PecaJosef/PCK-HC/Firmware/TouchGFX/assets/images/image-mesh-gradient_480x1920.png

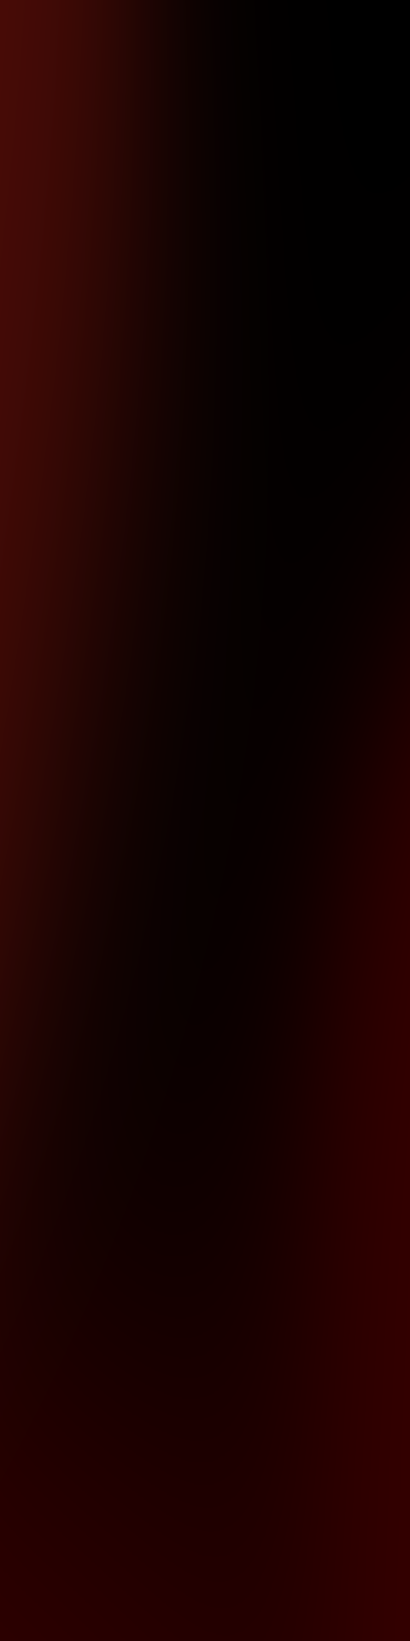
Firmware/TouchGFX/assets/images/image-mesh-gradient_480x1920.png
