PecaJosef/PCK-HC/Firmware/TouchGFX/assets/images/image-mesh-gradient 3.png

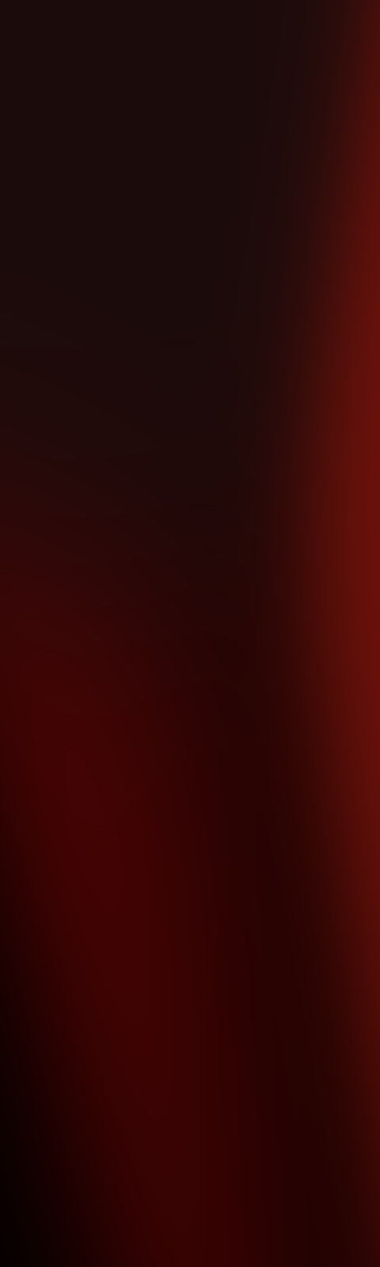
Firmware/TouchGFX/assets/images/image-mesh-gradient 3.png
