PecaJosef/PCK-HC/Firmware/TouchGFX/assets/images/image-mesh-gradient 2.png

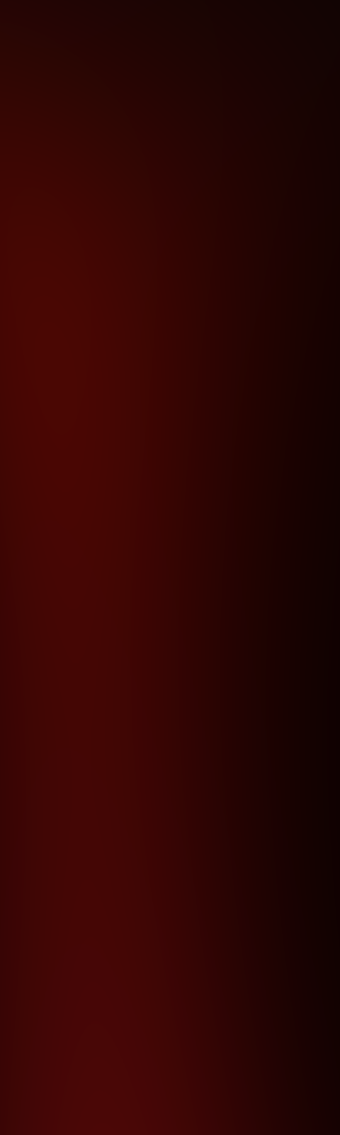
Firmware/TouchGFX/assets/images/image-mesh-gradient 2.png
