PecaJosef/PCK-HC/Firmware/TouchGFX/assets/images/image-mesh-gradient.png

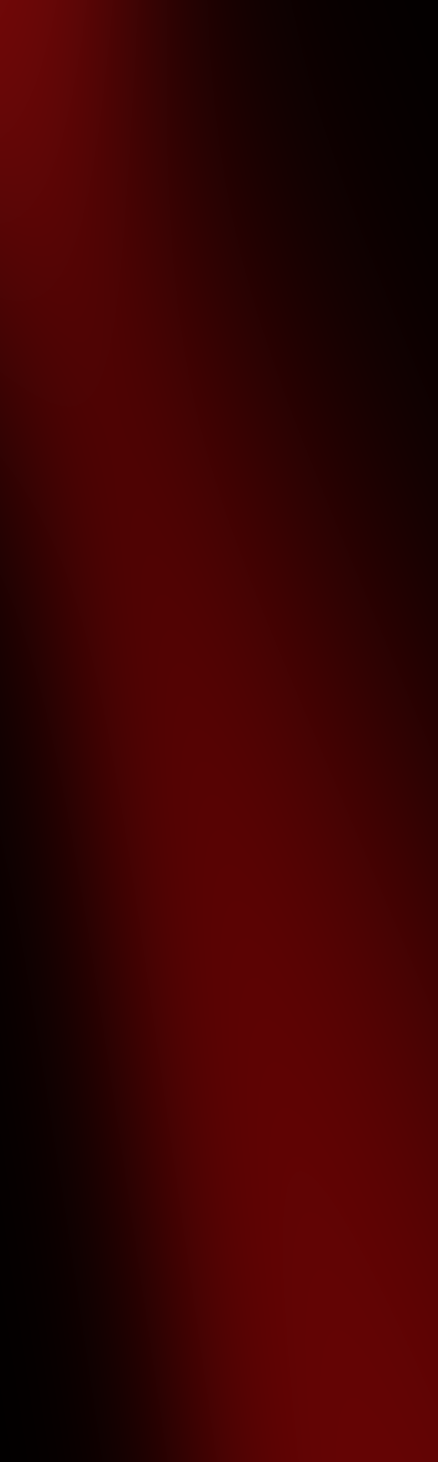
Firmware/TouchGFX/assets/images/image-mesh-gradient.png
