PecaJosef/PCK-HC/Firmware/TouchGFX/assets/images/PCK-ST1_120x120.png

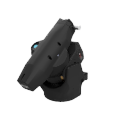
Firmware/TouchGFX/assets/images/PCK-ST1_120x120.png
