PecaJosef/PCK-HC/Firmware/TouchGFX/assets/images/PCK-ST1_240x240.png

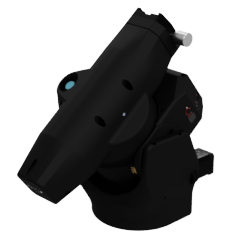
Firmware/TouchGFX/assets/images/PCK-ST1_240x240.png
