PecaJosef/PCK-HC/Controller/Controller board/Controller_board/As built V0.1/Controller_board.kicad_pcb

## KiCad design Controller/Controller board/Controller_board/As built V0.1/Controller_board.kicad_pcb (2026-10-08)

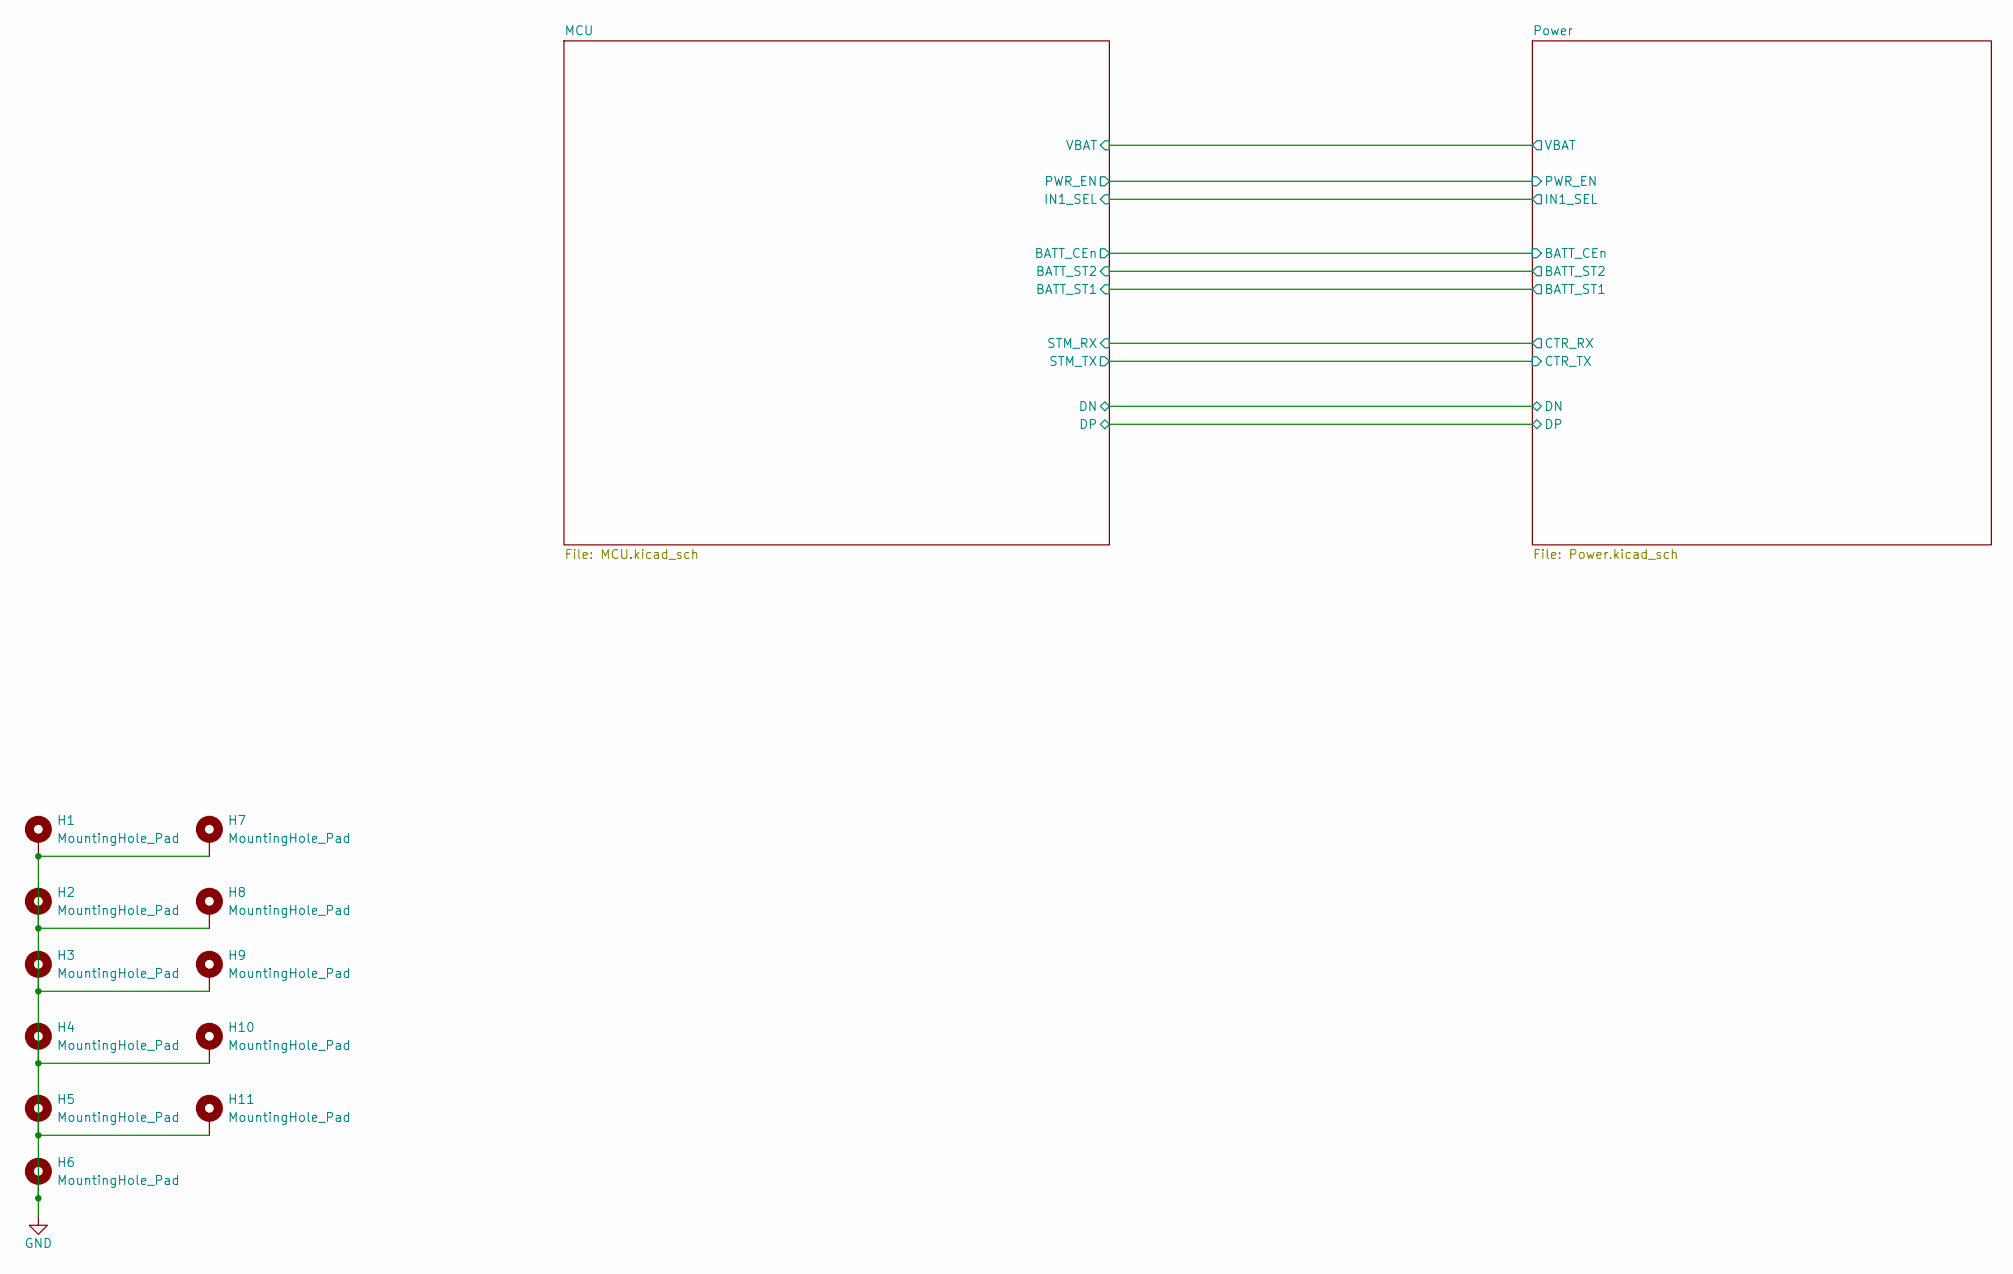
[picture p7: schematic Controller_board.kicad_sch]

Parts:
H1, H2, H3, H4, H5, H6, H7, H8, H9, H10, H11: MountingHole_Pad; MountingHole_3.2mm_M3_DIN965_Pad

Connections:
GND: H1.1, H2.1, H3.1, H4.1, H5.1, H6.1, H7.1, H8.1, H9.1, H10.1, H11.1; also elsewhere on the board

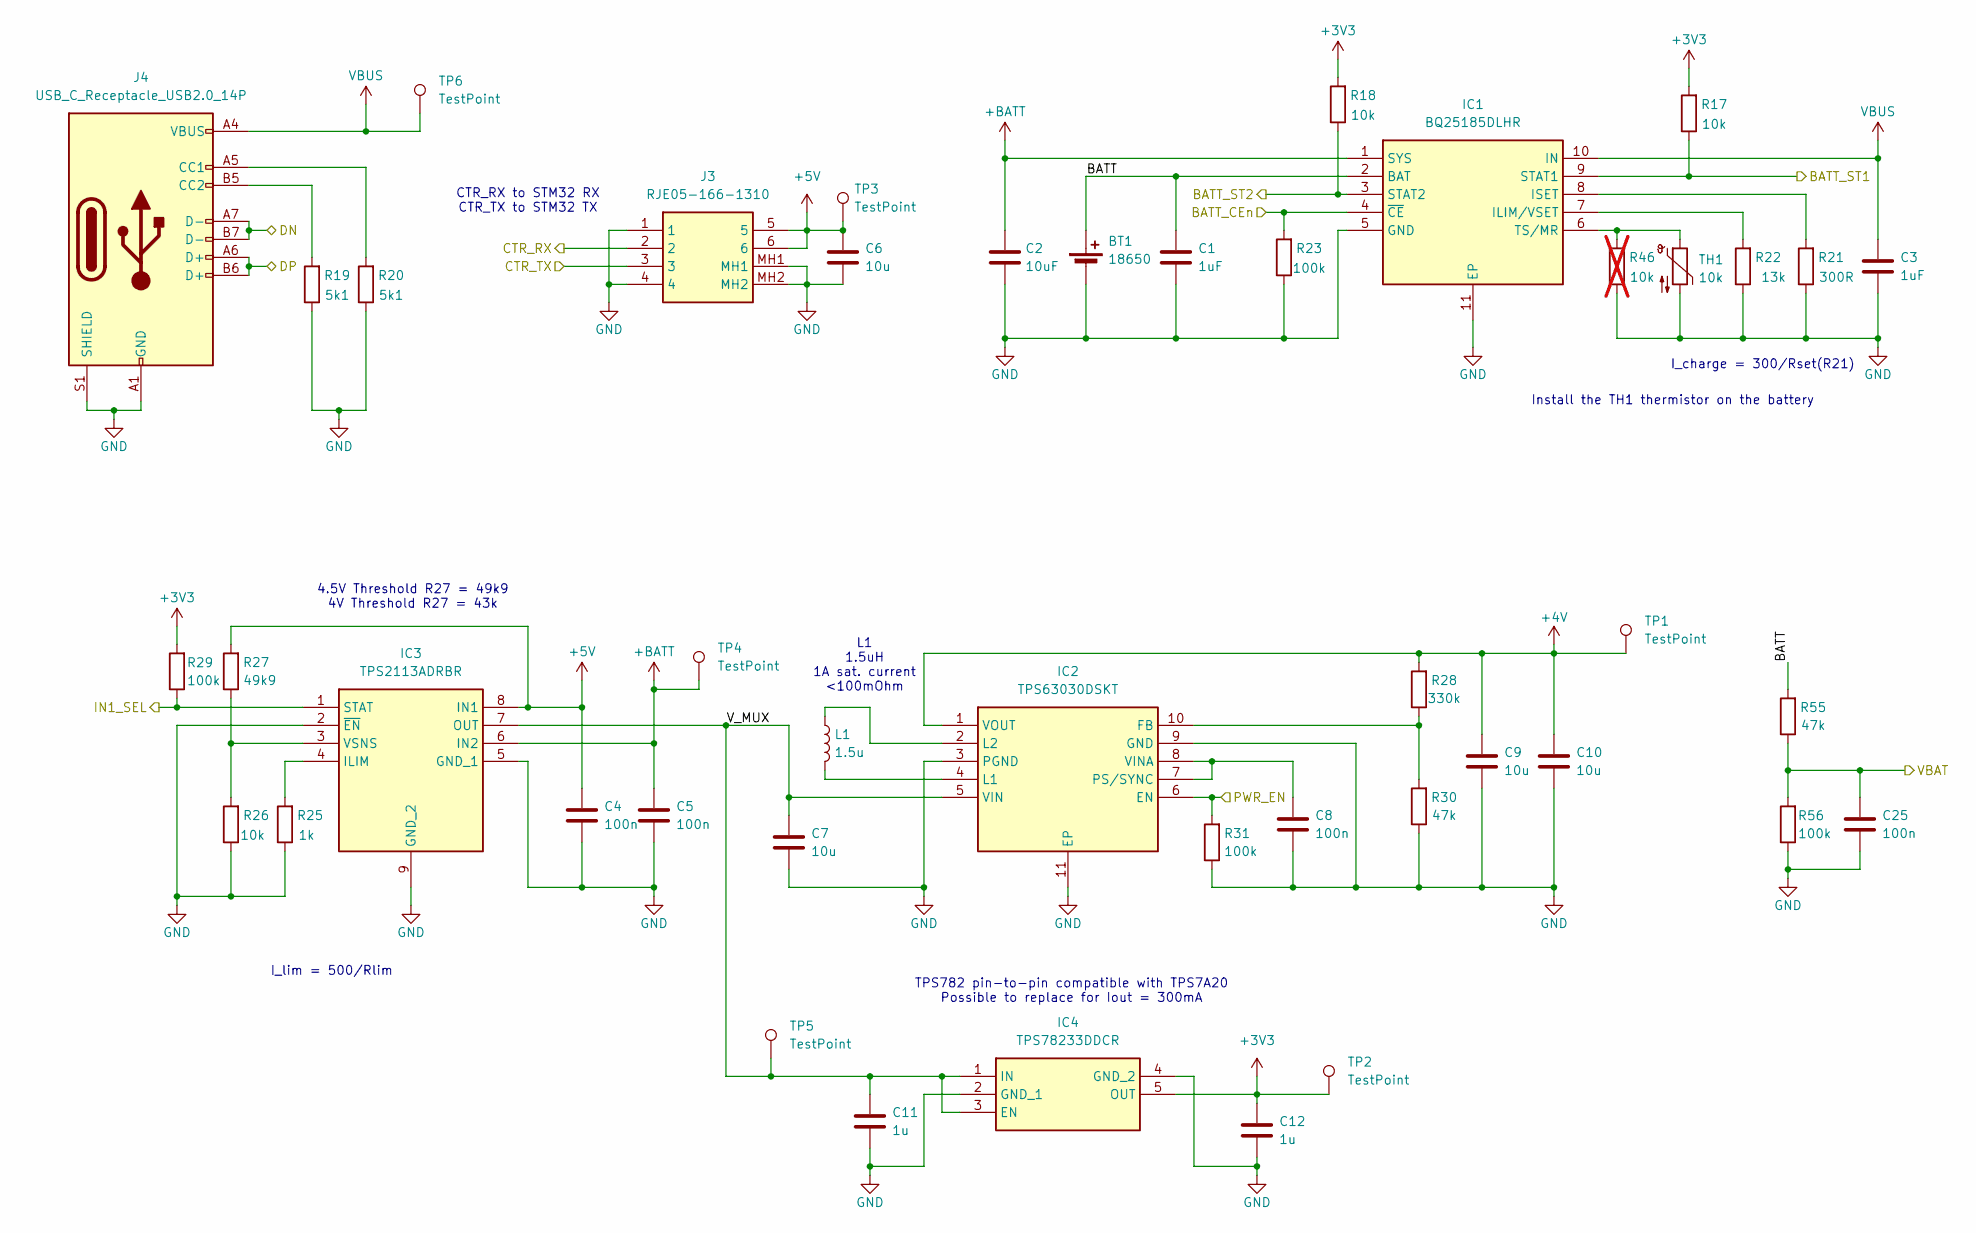
[picture p8: schematic Power.kicad_sch]

Parts:
BT1: 18650; BatteryHolder_Keystone_1042_1x18650
C1, C3: 1uF; C_0603_1608Metric
C2: 10uF; C_0603_1608Metric
C4, C5, C8, C25: 100n; C_0603_1608Metric
C6, C7, C9, C10: 10u; C_0603_1608Metric
C11, C12: 1u; C_0603_1608Metric
IC1: BQ25185DLHR; SON40P220X200X80-11N; Mouser Part Number 595-BQ25185DLHR
IC2: TPS63030DSKT; SON50P250X250X80-11N-D; Mouser Part Number 595-TPS63030DSKT
IC3: TPS2113ADRBR; SON65P300X300X100-9N-D; Mouser Part Number 595-TPS2113ADRBR
IC4: TPS78233DDCR; SOT95P280X110-5N; Mouser Part Number 595-TPS78233DDCR
J3: RJE05-166-1310; RJE051661310; Mouser Part Number 523-RJE05-166-1310
J4: USB_C_Receptacle_USB2.0_14P; USB_C_Receptacle_HCTL_HC-TYPE-C-16P-01A
L1: 1.5u; L_1008_2520Metric
R17, R18, R26: 10k; R_0603_1608Metric
R19, R20: 5k1; R_0603_1608Metric
R21: 300R; R_0603_1608Metric
R22: 13k; R_0603_1608Metric
R23, R29, R31, R56: 100k; R_0603_1608Metric
R25: 1k; R_0603_1608Metric
R27: 49k9; R_0603_1608Metric
R28: 330k; R_0603_1608Metric
R30, R55: 47k; R_0603_1608Metric
R46: 10k; R_0603_1608Metric; not fitted
TH1: 10k; JST_PH_B2B-PH-K_1x02_P2.00mm_Vertical
TP1, TP2, TP3, TP4, TP5, TP6: TestPoint; TestPoint_Pad_D1.5mm

Connections:
+3V3: C12.1, IC4.5 (OUT), R17.2, R18.2, R29.2, TP2.1; also elsewhere on the board
+4V: C9.1, C10.1, IC2.1 (VOUT), R28.2, TP1.1; also elsewhere on the board
+5V: C4.1, C6.1, IC3.8 (IN1), J3.5, J3.6, R27.2, TP3.1
+BATT: C2.1, C5.1, IC1.1 (SYS), IC3.6 (IN2), TP4.1
/MCU/BATT_CEn: IC1.4 (~CE), R23.2; also elsewhere on the board
/MCU/BATT_ST1: IC1.9 (STAT1), R17.1; also elsewhere on the board
/MCU/BATT_ST2: IC1.3 (STAT2), R18.1; also elsewhere on the board
/MCU/DN: J4.A7 (D-), J4.B7 (D-); also elsewhere on the board
/MCU/DP: J4.A6 (D+), J4.B6 (D+); also elsewhere on the board
/MCU/IN1_SEL: IC3.1 (STAT), R29.1; also elsewhere on the board
/MCU/PWR_EN: IC2.6 (EN), R31.2; also elsewhere on the board
/MCU/STM_RX: J3.2; also elsewhere on the board
/MCU/STM_TX: J3.3; also elsewhere on the board
/MCU/VBAT: C25.1, R55.1, R56.2; also elsewhere on the board
/Power/BATT: BT1.1 (+), C1.1, IC1.2 (BAT), R55.2
/Power/V_MUX: C7.1, C11.1, IC2.5 (VIN), IC3.7 (OUT), IC4.1 (IN), IC4.3 (EN), TP5.1
GND: BT1.2 (-), C1.2, C2.2, C3.2, C4.2, C5.2, C6.2, C7.2, C8.2, C9.2, C10.2, C11.2, C12.2, C25.2, IC1.5 (GND), IC1.11 (EP), IC2.3 (PGND), IC2.9 (GND), IC2.11 (EP), IC3.2 (~EN), IC3.5 (GND_1), IC3.9 (GND_2), IC4.2 (GND_1), IC4.4 (GND_2), J3.1, J3.4, J3.MH1, J3.MH2, J4.A1 (GND), J4.A12 (GND), J4.B1 (GND), J4.B12 (GND), J4.S1 (SHIELD), R19.1, R20.1, R21.1, R22.1, R23.1, R25.1, R26.1, R30.1, R31.1, R46.1, R56.1, TH1.2; also elsewhere on the board
unnamed: IC1.7 (ILIM/VSET), R22.2
unnamed: IC1.8 (ISET), R21.2
unnamed: IC1.6 (TS/MR), R46.2, TH1.1
unnamed: IC2.10 (FB), R28.1, R30.2
unnamed: IC2.4 (L1), L1.2
unnamed: IC2.2 (L2), L1.1
unnamed: C8.1, IC2.7 (PS/SYNC), IC2.8 (VINA)
unnamed: IC3.4 (ILIM), R25.2
unnamed: IC3.3 (VSNS), R26.2, R27.1
unnamed: J4.A5 (CC1), R20.2
unnamed: J4.B5 (CC2), R19.2
VBUS: C3.1, IC1.10 (IN), J4.A4 (VBUS), J4.A9 (VBUS), J4.B4 (VBUS), J4.B9 (VBUS), TP6.1

Notes on the sheet:
CTR_RX to STM32 RX CTR_TX to STM32 TX
Install the TH1 thermistor on the battery
I_charge = 300/Rset(R21)
I_lim = 500/Rlim
4.5V Threshold R27 = 49k9 4V Threshold R27 = 43k
TPS782 pin-to-pin compatible with TPS7A20 Possible to replace for Iout = 300mA
L1 1.5uH 1A sat. current <100mOhm

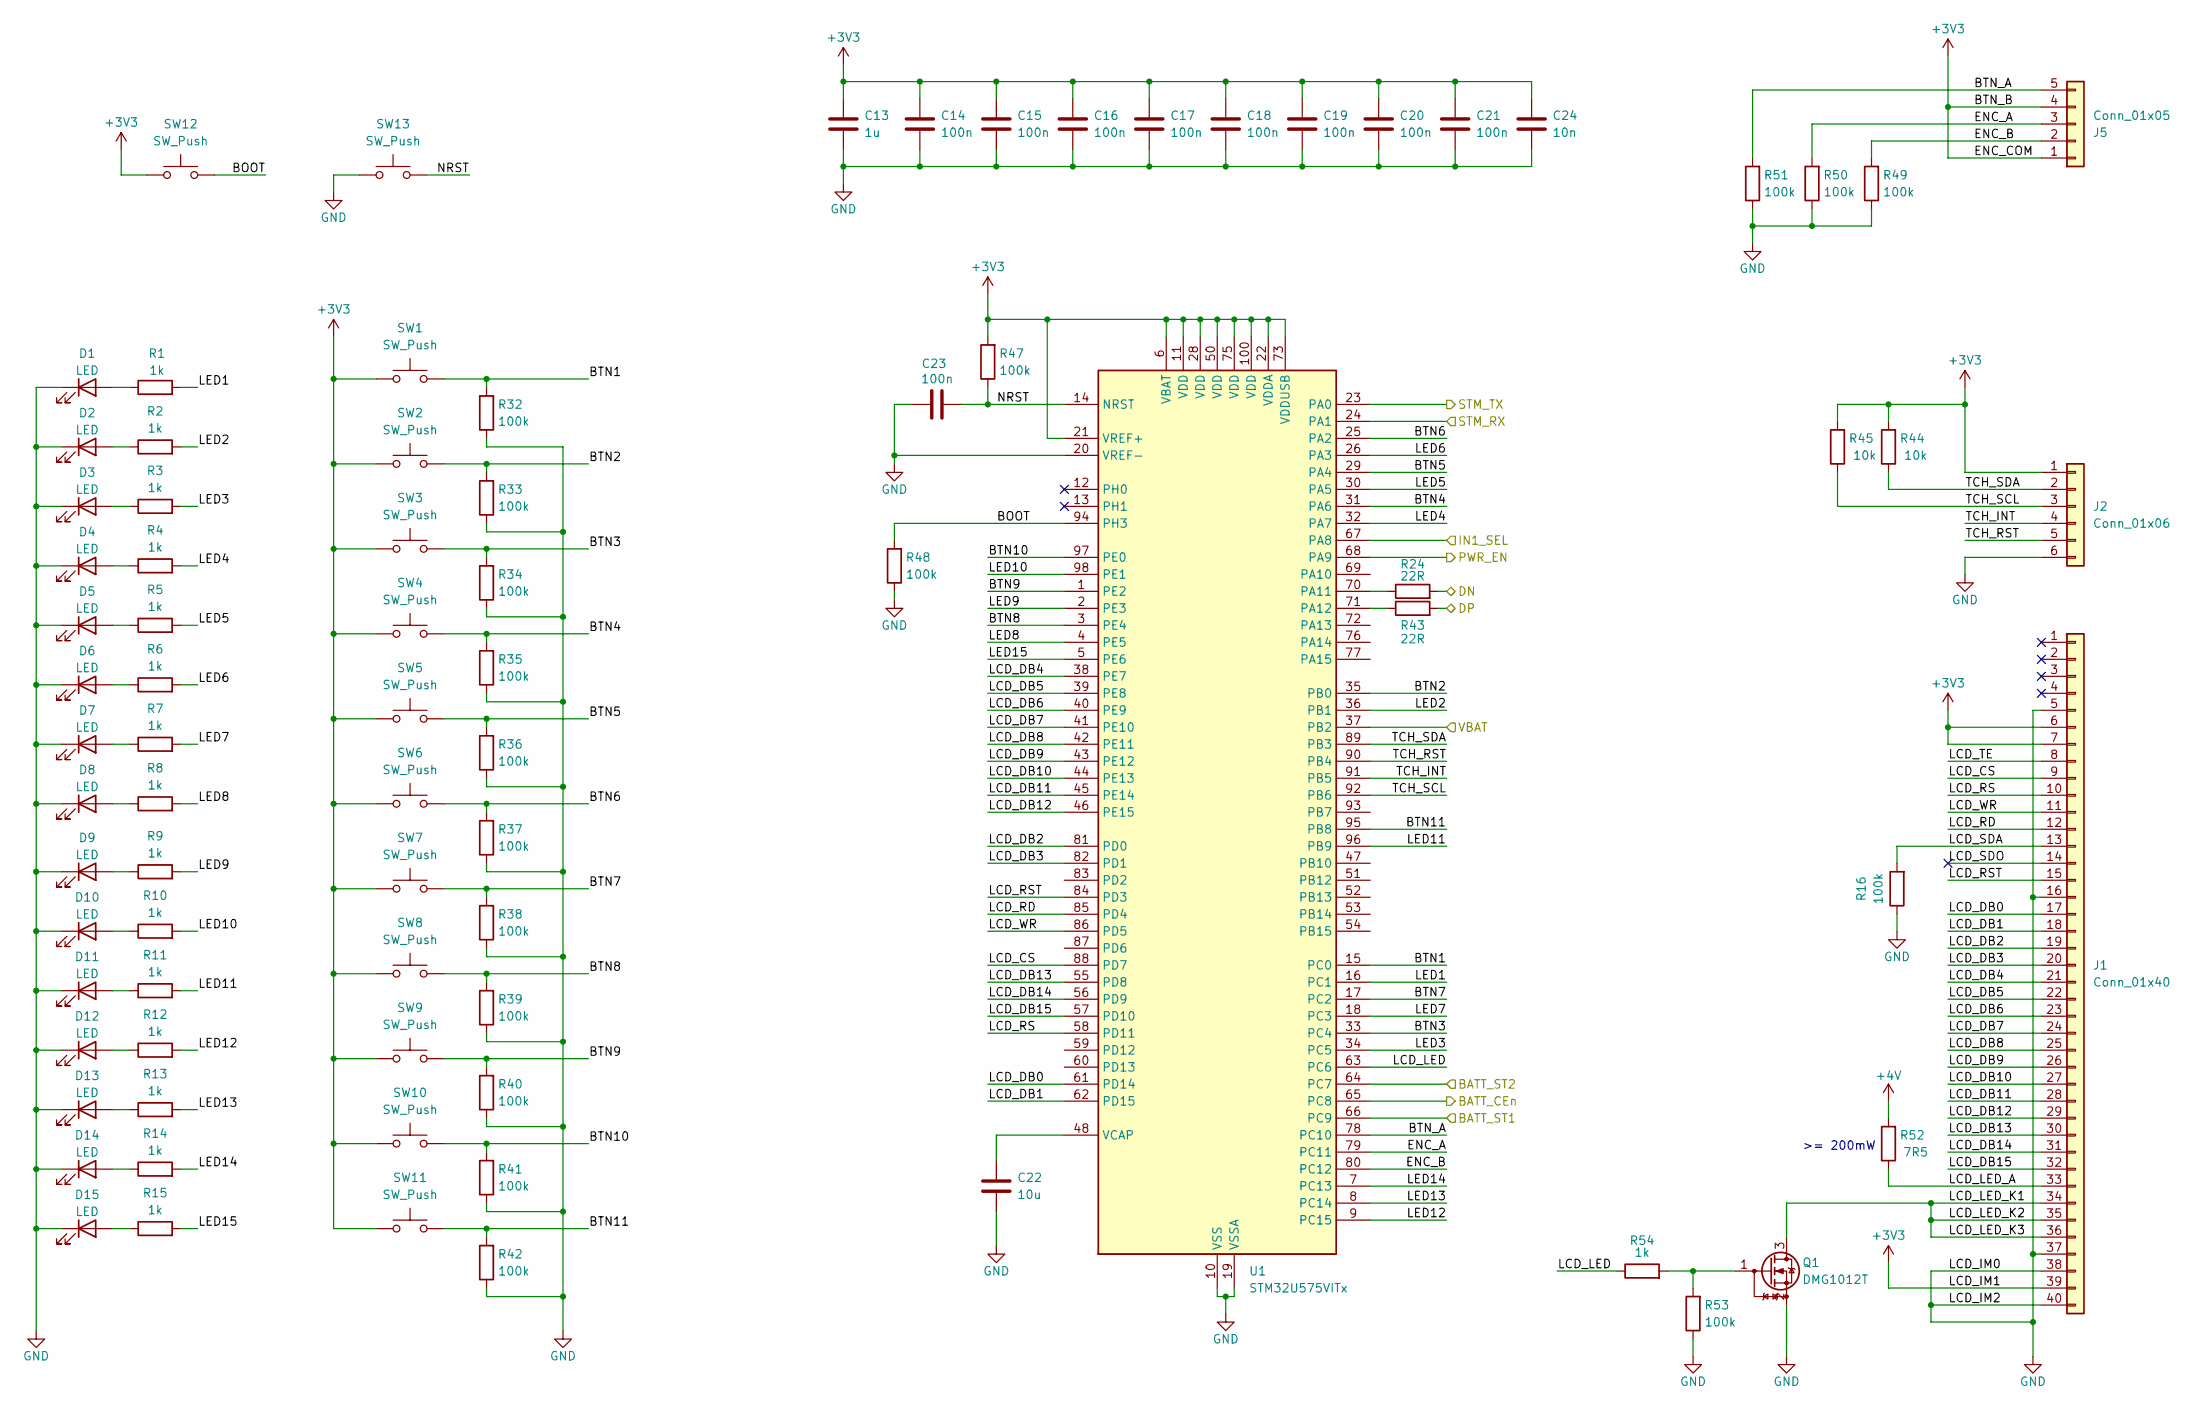
[picture p9: schematic MCU.kicad_sch]

Parts:
C13: 1u; C_0603_1608Metric
C14, C15, C16, C17, C18, C19, C20, C21, C23: 100n; C_0603_1608Metric
C22: 10u; C_0603_1608Metric
C24: 10n; C_0603_1608Metric
D1, D2, D3, D4, D5, D6, D7, D8, D9, D10, D11, D12, D13, D14, D15: LED; LED_0603_1608Metric
J1: Conn_01x40; FPC_P0.50mm_Horizontal_40P
J2: Conn_01x06; Hirose_FH12-6S-0.5SH_1x06-1MP_P0.50mm_Horizontal
J5: Conn_01x05; JST_PH_B5B-PH-K_1x05_P2.00mm_Vertical
Q1: DMG1012T; SOT-523
R1, R2, R3, R4, R5, R6, R7, R8, R9, R10, R11, R12, R13, R14, R15, R54: 1k; R_0603_1608Metric
R16, R32, R33, R34, R35, R36, R37, R38, R39, R40, R41, R42, R47, R48, R49, R50, R51, R53: 100k; R_0603_1608Metric
R24, R43: 22R; R_0603_1608Metric
R44, R45: 10k; R_0603_1608Metric
R52: 7R5; R_0805_2012Metric
SW1, SW2, SW3, SW4, SW5, SW6, SW7, SW8, SW9, SW10, SW11, SW12, SW13: SW_Push; SW_SPST_PTS645Sx43SMTR92
U1: STM32U575VITx; LQFP-100_14x14mm_P0.5mm

Connections:
+3V3: C13.1, C14.1, C15.1, C16.1, C17.1, C18.1, C19.1, C20.1, C21.1, C24.1, J1.6, J1.7, J1.39, J2.1, J5.1, J5.4, R44.2, R45.2, R47.2, SW1.1, SW2.1, SW3.1, SW4.1, SW5.1, SW6.1, SW7.1, SW8.1, SW9.1, SW10.1, SW11.1, SW12.1, U1.6 (VBAT), U1.11 (VDD), U1.21 (VREF+), U1.22 (VDDA), U1.28 (VDD), U1.50 (VDD), U1.73 (VDDUSB), U1.75 (VDD), U1.100 (VDD); also elsewhere on the board
+4V: R52.2; also elsewhere on the board
/MCU/BATT_CEn: U1.65 (PC8); also elsewhere on the board
/MCU/BATT_ST1: U1.66 (PC9); also elsewhere on the board
/MCU/BATT_ST2: U1.64 (PC7); also elsewhere on the board
/MCU/BOOT: R48.2, SW12.2, U1.94 (PH3)
/MCU/BTN1: R32.2, SW1.2, U1.15 (PC0)
/MCU/BTN2: R33.2, SW2.2, U1.35 (PB0)
/MCU/BTN3: R34.2, SW3.2, U1.33 (PC4)
/MCU/BTN4: R35.2, SW4.2, U1.31 (PA6)
/MCU/BTN5: R36.2, SW5.2, U1.29 (PA4)
/MCU/BTN6: R37.2, SW6.2, U1.25 (PA2)
/MCU/BTN7: R38.2, SW7.2, U1.17 (PC2)
/MCU/BTN8: R39.2, SW8.2, U1.3 (PE4)
/MCU/BTN9: R40.2, SW9.2, U1.1 (PE2)
/MCU/BTN10: R41.2, SW10.2, U1.97 (PE0)
/MCU/BTN11: R42.2, SW11.2, U1.95 (PB8)
/MCU/BTN_A: J5.5, R51.2, U1.78 (PC10)
/MCU/DN: R24.2; also elsewhere on the board
/MCU/DP: R43.2; also elsewhere on the board
/MCU/ENC_A: J5.3, R50.2, U1.79 (PC11)
/MCU/ENC_B: J5.2, R49.2, U1.80 (PC12)
/MCU/IN1_SEL: U1.67 (PA8); also elsewhere on the board
/MCU/LCD_CS: J1.9, U1.88 (PD7)
/MCU/LCD_DB0: J1.17, U1.61 (PD14)
/MCU/LCD_DB1: J1.18, U1.62 (PD15)
/MCU/LCD_DB2: J1.19, U1.81 (PD0)
/MCU/LCD_DB3: J1.20, U1.82 (PD1)
/MCU/LCD_DB4: J1.21, U1.38 (PE7)
/MCU/LCD_DB5: J1.22, U1.39 (PE8)
/MCU/LCD_DB6: J1.23, U1.40 (PE9)
/MCU/LCD_DB7: J1.24, U1.41 (PE10)
/MCU/LCD_DB8: J1.25, U1.42 (PE11)
/MCU/LCD_DB9: J1.26, U1.43 (PE12)
/MCU/LCD_DB10: J1.27, U1.44 (PE13)
/MCU/LCD_DB11: J1.28, U1.45 (PE14)
/MCU/LCD_DB12: J1.29, U1.46 (PE15)
/MCU/LCD_DB13: J1.30, U1.55 (PD8)
/MCU/LCD_DB14: J1.31, U1.56 (PD9)
/MCU/LCD_DB15: J1.32, U1.57 (PD10)
/MCU/LCD_LED: R54.1, U1.63 (PC6)
/MCU/LCD_LED_A: J1.33, R52.1
/MCU/LCD_LED_K1: J1.34, J1.35, J1.36, Q1.3 (D)
/MCU/LCD_RD: J1.12, U1.85 (PD4)
/MCU/LCD_RS: J1.10, U1.58 (PD11)
/MCU/LCD_RST: J1.15, U1.84 (PD3)
/MCU/LCD_SDA: J1.13, R16.2
/MCU/LCD_SDO: J1.14
/MCU/LCD_TE: J1.8
/MCU/LCD_WR: J1.11, U1.86 (PD5)
/MCU/LED1: R1.2, U1.16 (PC1)
/MCU/LED2: R2.2, U1.36 (PB1)
/MCU/LED3: R3.2, U1.34 (PC5)
/MCU/LED4: R4.2, U1.32 (PA7)
/MCU/LED5: R5.2, U1.30 (PA5)
/MCU/LED6: R6.2, U1.26 (PA3)
/MCU/LED7: R7.2, U1.18 (PC3)
/MCU/LED8: R8.2, U1.4 (PE5)
/MCU/LED9: R9.2, U1.2 (PE3)
/MCU/LED10: R10.2, U1.98 (PE1)
/MCU/LED11: R11.2, U1.96 (PB9)
/MCU/LED12: R12.2, U1.9 (PC15)
/MCU/LED13: R13.2, U1.8 (PC14)
/MCU/LED14: R14.2, U1.7 (PC13)
/MCU/LED15: R15.2, U1.5 (PE6)
/MCU/NRST: C23.2, R47.1, SW13.2, U1.14 (NRST)
/MCU/PWR_EN: U1.68 (PA9); also elsewhere on the board
/MCU/STM_RX: U1.24 (PA1); also elsewhere on the board
/MCU/STM_TX: U1.23 (PA0); also elsewhere on the board
/MCU/TCH_INT: J2.4, U1.91 (PB5)
/MCU/TCH_RST: J2.5, U1.90 (PB4)
/MCU/TCH_SCL: J2.3, R45.1, U1.92 (PB6)
/MCU/TCH_SDA: J2.2, R44.1, U1.89 (PB3)
/MCU/VBAT: U1.37 (PB2); also elsewhere on the board
GND: C13.2, C14.2, C15.2, C16.2, C17.2, C18.2, C19.2, C20.2, C21.2, C22.2, C23.1, C24.2, D1.1 (K), D2.1 (K), D3.1 (K), D4.1 (K), D5.1 (K), D6.1 (K), D7.1 (K), D8.1 (K), D9.1 (K), D10.1 (K), D11.1 (K), D12.1 (K), D13.1 (K), D14.1 (K), D15.1 (K), J1.5, J1.16, J1.37, J1.38, J1.40, J2.6, Q1.2 (S), R16.1, R32.1, R33.1, R34.1, R35.1, R36.1, R37.1, R38.1, R39.1, R40.1, R41.1, R42.1, R48.1, R49.1, R50.1, R51.1, R53.1, SW13.1, U1.10 (VSS), U1.19 (VSSA), U1.20 (VREF-), U1.27 (VSS), U1.49 (VSS), U1.74 (VSS), U1.99 (VSS); also elsewhere on the board
unnamed: D1.2 (A), R1.1
unnamed: D2.2 (A), R2.1
unnamed: D3.2 (A), R3.1
unnamed: D4.2 (A), R4.1
unnamed: D5.2 (A), R5.1
unnamed: D6.2 (A), R6.1
unnamed: D7.2 (A), R7.1
unnamed: D8.2 (A), R8.1
unnamed: D9.2 (A), R9.1
unnamed: D10.2 (A), R10.1
unnamed: D11.2 (A), R11.1
unnamed: D12.2 (A), R12.1
unnamed: D13.2 (A), R13.1
unnamed: D14.2 (A), R14.1
unnamed: D15.2 (A), R15.1
unnamed: Q1.1 (G), R53.2, R54.2
unnamed: R24.1, U1.70 (PA11)
unnamed: R43.1, U1.71 (PA12)
unnamed: C22.1, U1.48 (VCAP)

Notes on the sheet:
>= 200mW

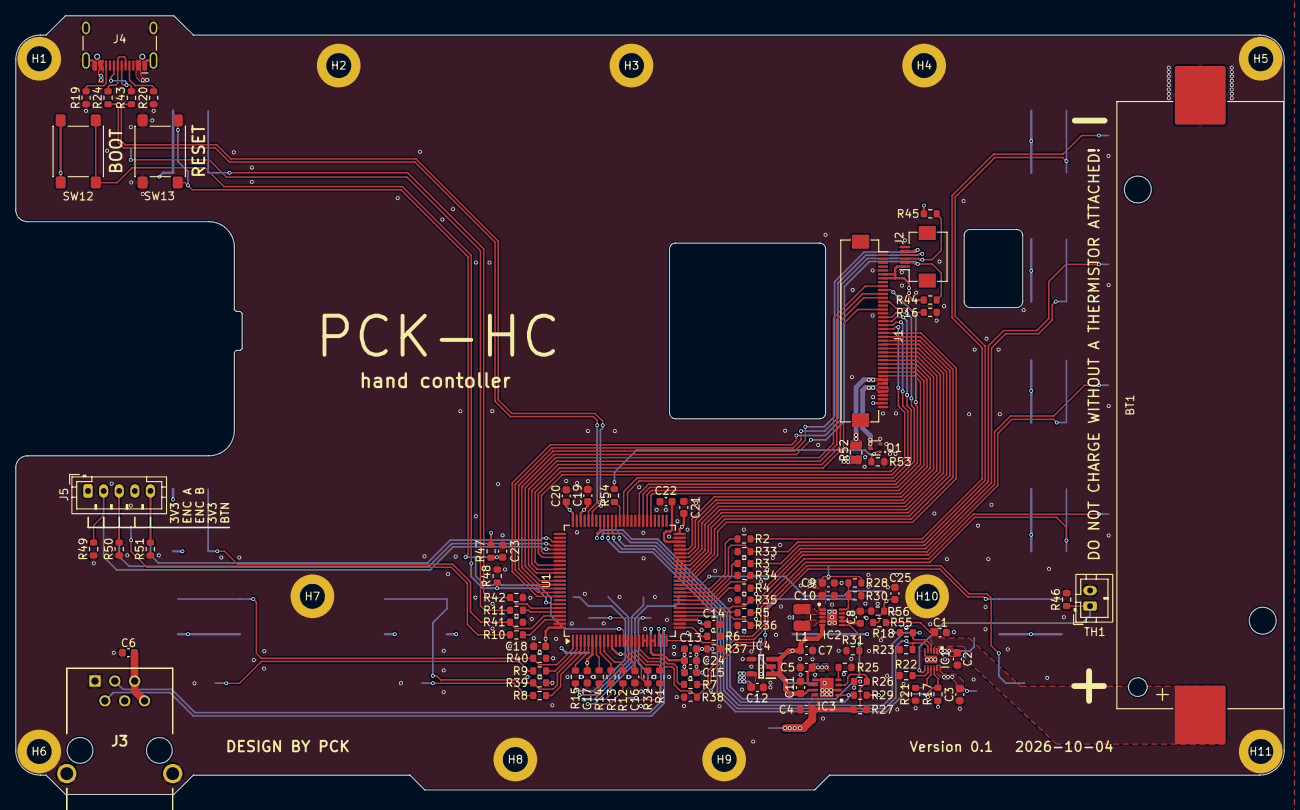
[picture p10: board Controller_board.kicad_pcb from above]

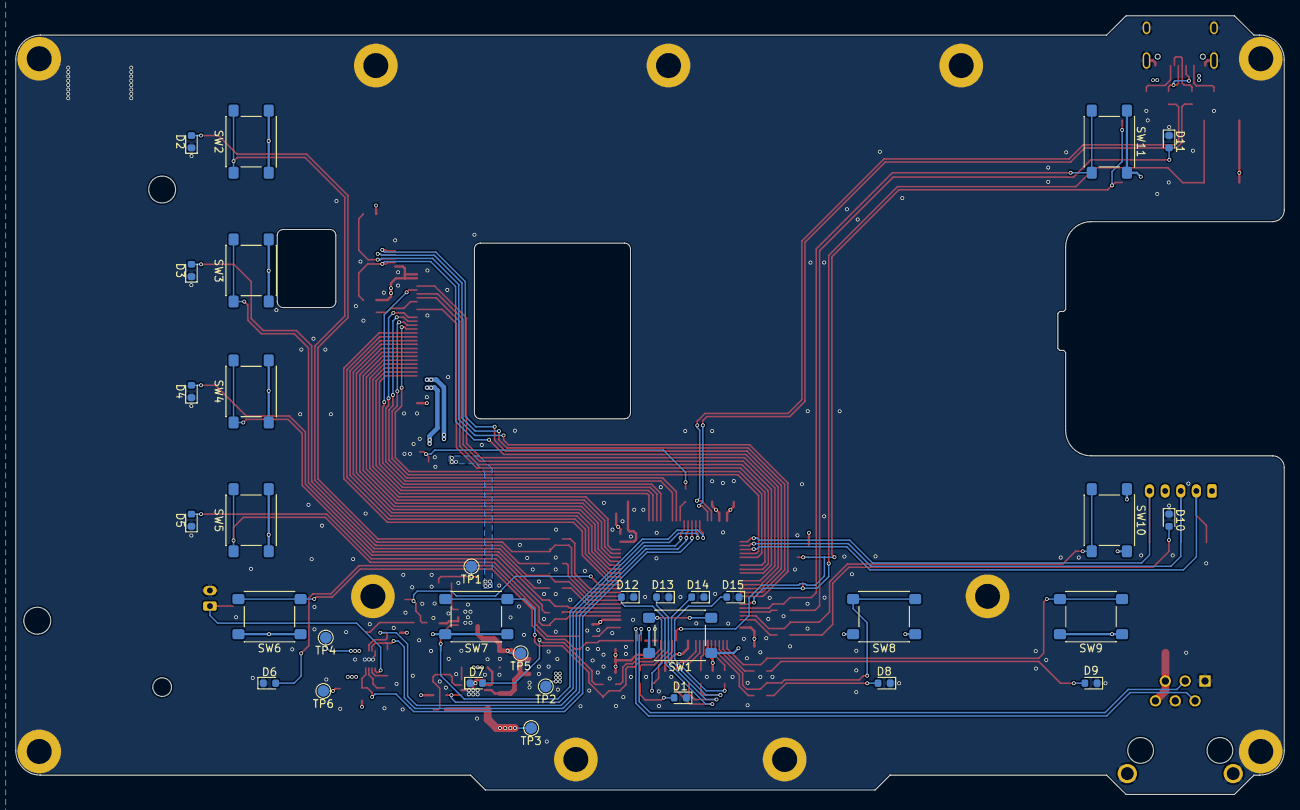
[picture p11: board Controller_board.kicad_pcb from below]

Board: 4 copper layers, 162.5 x 99.8 mm, 140 parts (32 on the bottom side), 108 nets.
