PecaJosef/PCK-HC/Controller/Scrollwheel board/Scrollwheel_board.kicad_pcb

## KiCad design Controller/Scrollwheel board/Scrollwheel_board.kicad_pcb (2026-10-08)

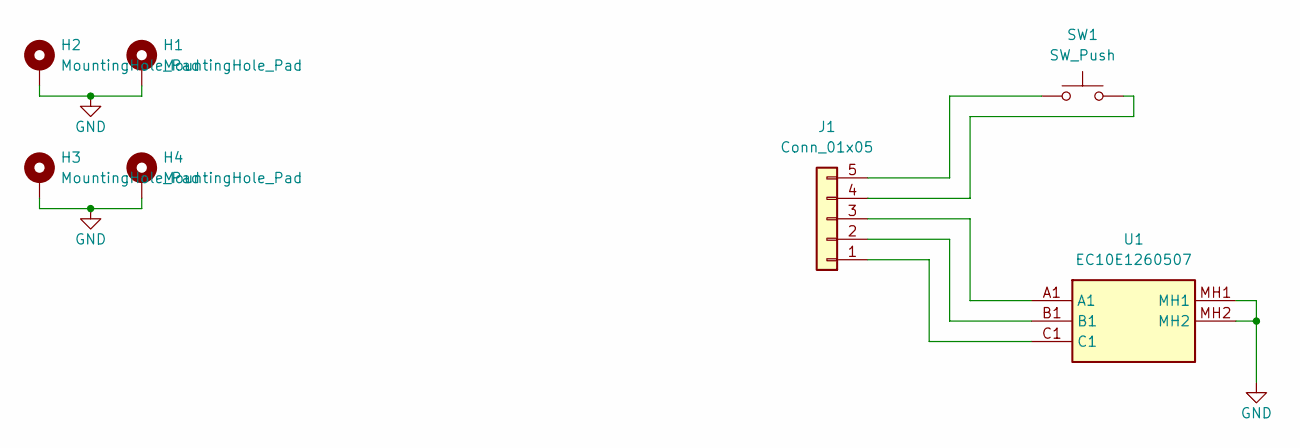
[picture p12: schematic Scrollwheel_board.kicad_sch]

Parts:
H1, H2, H3, H4: MountingHole_Pad; MountingHole_3.2mm_M3_DIN965_Pad
J1: Conn_01x05; JST_PH_B5B-PH-K_1x05_P2.00mm_Vertical
SW1: SW_Push; SW_SPST_PTS645Sx43SMTR92
U1: EC10E1260507; Mouser Part Number 688-EC10E1260507

Connections:
GND: H1.1, H2.1, H3.1, H4.1, U1.MH1, U1.MH2
unnamed: J1.1, U1.C1
unnamed: J1.2, U1.B1
unnamed: J1.3, U1.A1
unnamed: J1.4, SW1.2
unnamed: J1.5, SW1.1

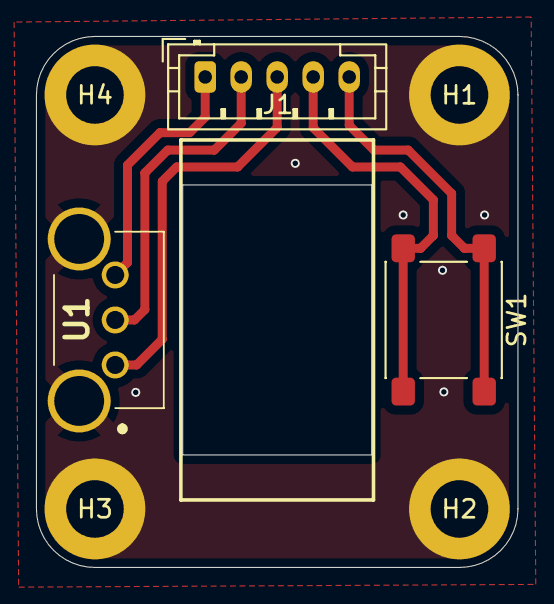
[picture p13: board Scrollwheel_board.kicad_pcb from above]

Board: 2 copper layers, 26.8 x 29.5 mm, 7 parts (0 on the bottom side), 6 nets.
