PecaJosef/PCK-HC/Firmware/PCK-STC.ioc

Mcu.UserName=STM32U575VITx
PA0.Signal=UART4_TX
PA1.Signal=UART4_RX
PA11.Signal=USB_OTG_FS_DM
PA12.Signal=USB_OTG_FS_DP
PB6.Signal=I2C1_SCL
PD0.Signal=FMC_D2
PD1.Signal=FMC_D3
PD10.Signal=FMC_D15
PD11.Signal=FMC_A16
PD14.Signal=FMC_D0
PD15.Signal=FMC_D1
PD4.Signal=FMC_NOE
PD5.Signal=FMC_NWE
PD7.Signal=FMC_NE1
PD8.Signal=FMC_D13
PD9.Signal=FMC_D14
PE10.Signal=FMC_D7
PE11.Signal=FMC_D8
PE12.Signal=FMC_D9
PE13.Signal=FMC_D10
PE14.Signal=FMC_D11
PE15.Signal=FMC_D12
PE7.Signal=FMC_D4
PE8.Signal=FMC_D5
PE9.Signal=FMC_D6
